HWXLR8/niubkb/README.md

# 牛逼KB
An ergonomic ortholinear keyboard inspired by the Atrues.
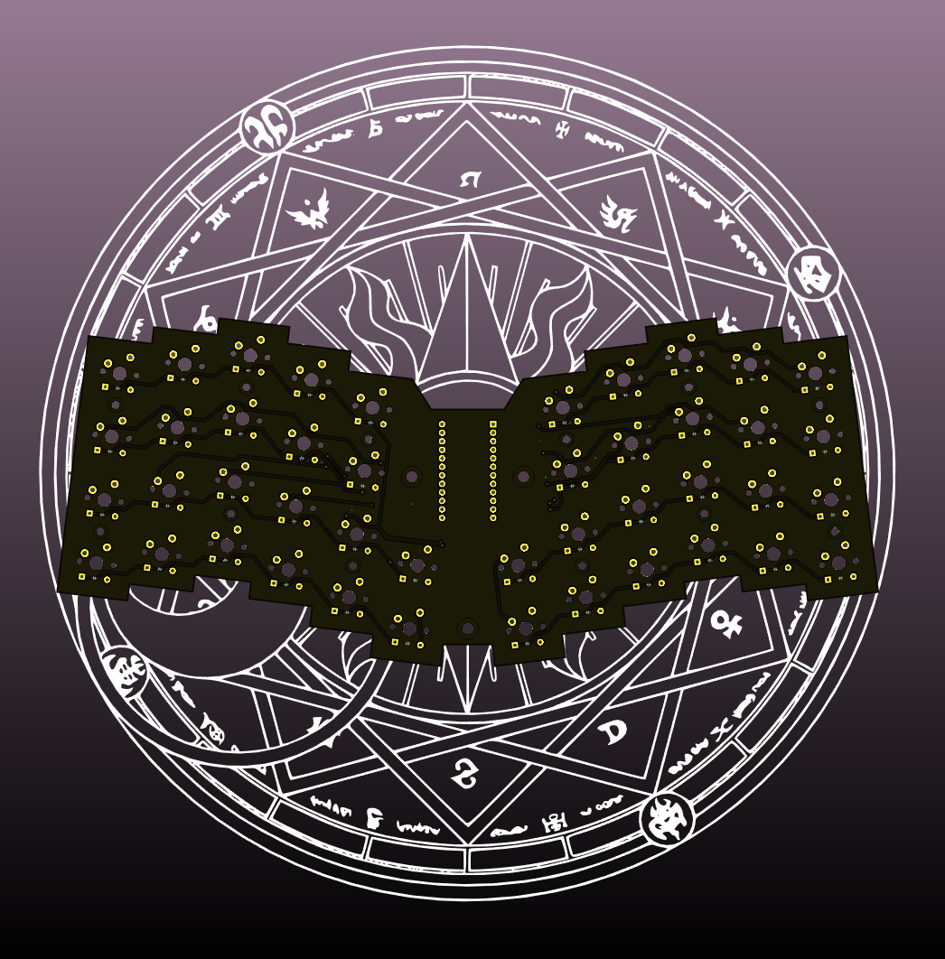
[picture p1: pcb/pic/pcb.png]
