HWXLR8/niubkb/fw/README.md

### Layout

L0

```
    =      Q     W     F     P     G         ||        J     L     U     Y     ;     `
    /      A     R     S     T     D         ||        H     N     E     I     O     '
    FN     Z     X     C     V     B    DEL  ||  ×     K     M     ,     .     ×     ×
    ESC    ×     ×    GUI  SHIFT  BSPC  CTRL || ALT  SPACE   FN    -     ×     ×   ENTER
```

L1

```
    ×     !     @     UP    {     }         ||       PGUP   7     8     9     *     ×
    ×     #    LEFT  DOWN RIGHT   $         ||       PGDN   4     5     6     +     ×
    ×     [     ]     (     )     &     ×   ||  ×     ×     1     2     3     \     ×
    ×     ×    INS   GUI  SHIFT  BSPC  CTRL || ALT  SPACE   ×     .     0     =     ×
```

Hold `FN` for layer 1. `×` is unmapped; on higher layers it falls back to the layer below.
