HWXLR8/niubkb/case/dxf/base_left.dxf

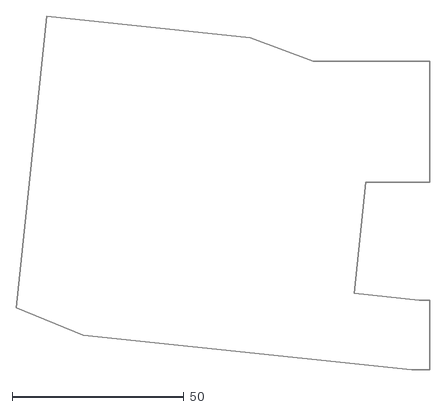
[picture p2: CAD file, 2024-02-07]
case/dxf/base_left.dxf
120.7 x 103.1
