HWXLR8/niubkb/case/dxf/hole_support_left.dxf

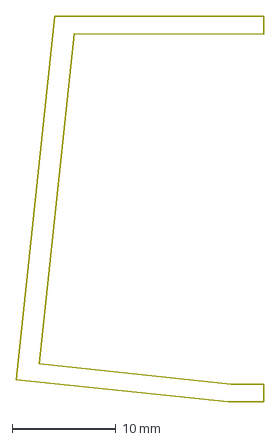
[picture p3: CAD file, 2024-02-07]
case/dxf/hole_support_left.dxf
23.9 x 37.2 mm
