HWXLR8/niubkb/case/dxf/base.dxf

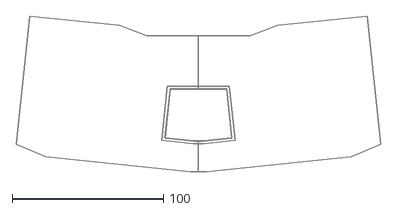
[picture p4: CAD file, 2024-02-07]
case/dxf/base.dxf
241.3 x 103.1
