HWXLR8/niubkb/case/dxf/outline.dxf

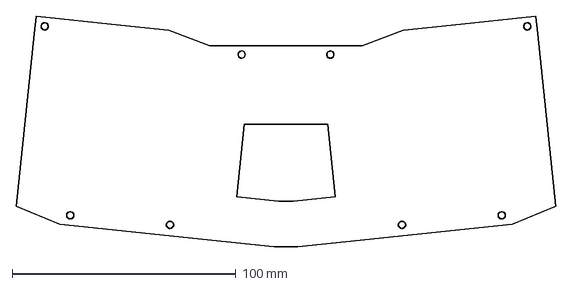
[picture p5: CAD file, 2024-02-07]
case/dxf/outline.dxf
241.3 x 103.1 mm
