HWXLR8/niubkb/pcb/niu-v5.kicad_pcb

## KiCad design pcb/niu-v5.kicad_pcb (2025-12-14)

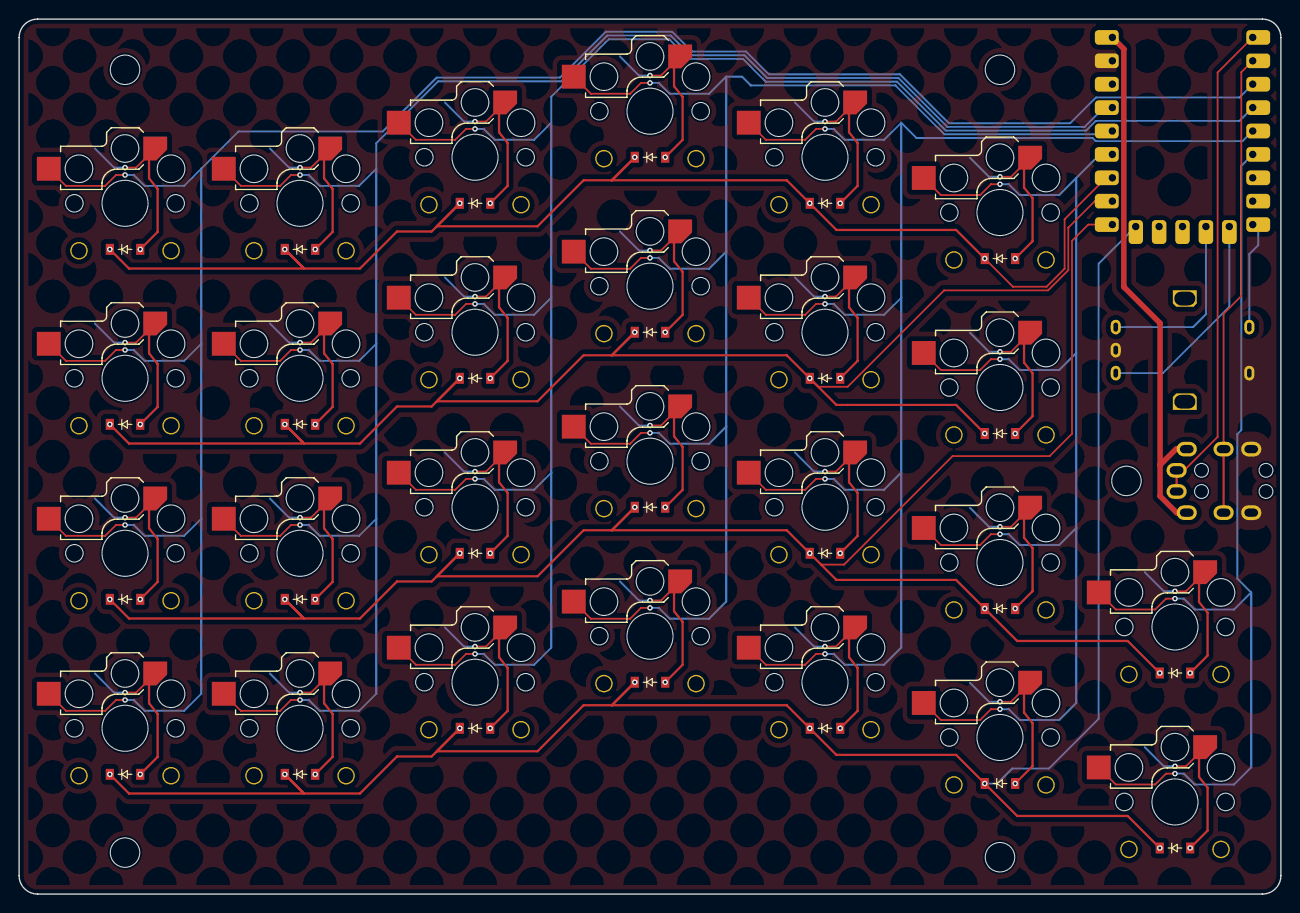
[picture p6: board niu-v5.kicad_pcb from above]

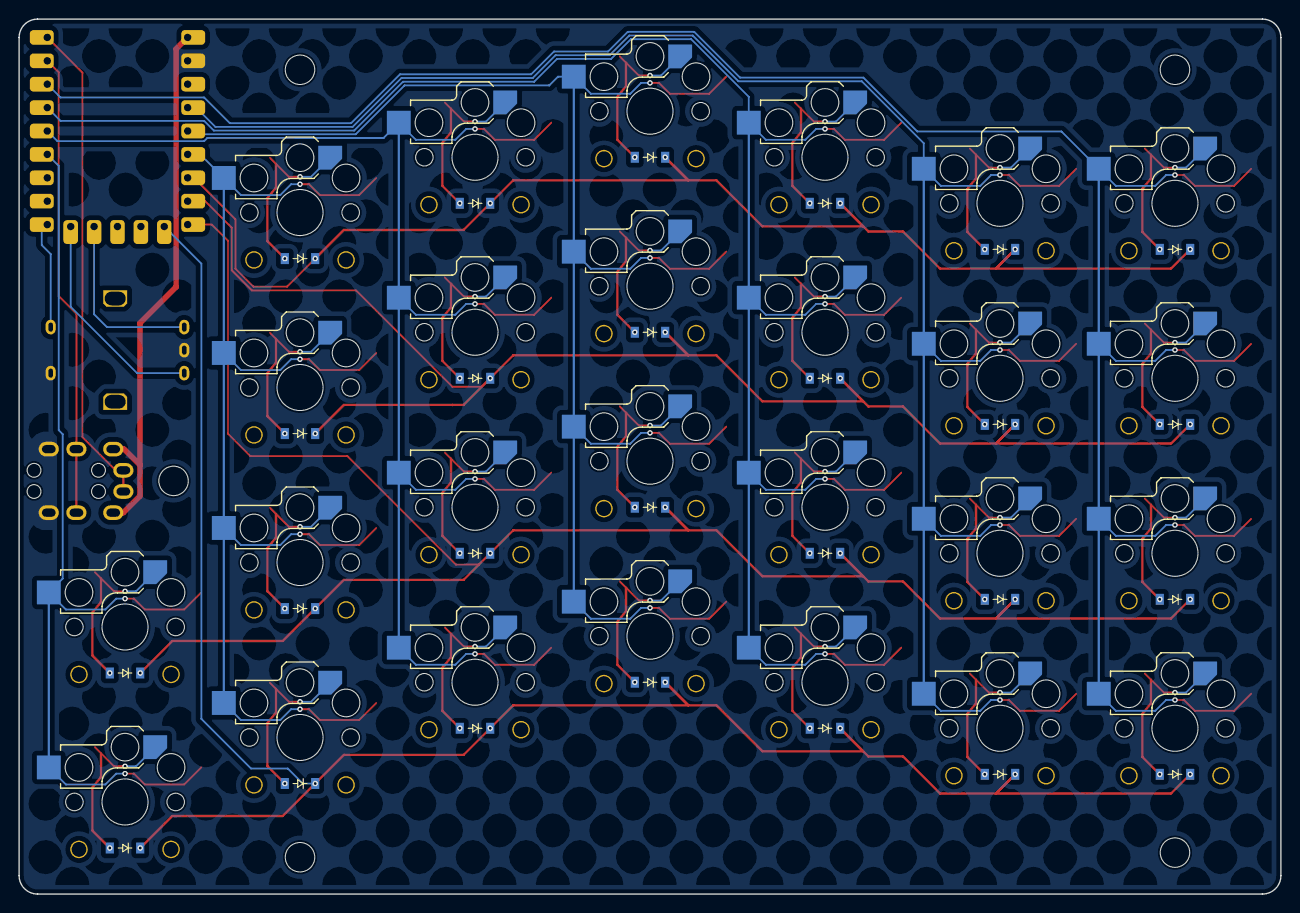
[picture p7: board niu-v5.kicad_pcb from below]

Board: 2 copper layers, 137.0 x 95.0 mm, 60 parts (26 on the bottom side), 44 nets.

Parts:
D1, D2, D3, D4, D5, D6, D7, D8, D9, D10, D11, D12, D13, D14, D15, D16, D17, D18, D19, D20, D21, D22, D23, D24, D25, D26: diode_tht_sod123
MCU1: mcu_rp2040_zero
MH1, MH2, MH3, MH4, MH5: mounting_hole_npth
RE1: rotary_encoder_ec11_ec12
S1, S2, S3, S4, S5, S6, S7, S8, S9, S10, S11, S12, S13, S14, S15, S16, S17, S18, S19, S20, S21, S22, S23, S24, S25, S26: switch_choc_v1_v2
TRRS1: trrs_pj320a (reversible)

Connections:
5V: MCU1.1, TRRS1.4
ENC_A: MCU1.14, RE1.A
ENC_B: MCU1.13, RE1.C
ENC_SW: MCU1.15, RE1.S1
GND: MCU1.2, RE1.B, RE1.S2, TRRS1.2
P4: MCU1.4, S5.2, S6.2, S7.2, S8.2
P5: MCU1.5, S13.2, S14.2, S15.2, S16.2
P6: MCU1.6, S21.2, S22.2, S23.2, S24.2
P7: D4.1, D8.1, D12.1, D16.1, D20.1, D24.1, MCU1.7
P8: D3.1, D7.1, D11.1, D15.1, D19.1, D23.1, MCU1.8
P9: D2.1, D6.1, D10.1, D14.1, D18.1, D22.1, D26.1, MCU1.9
P10: D1.1, D5.1, D9.1, D13.1, D17.1, D21.1, D25.1, MCU1.10
P18: MCU1.18, S25.2, S26.2
P19: MCU1.19, S17.2, S18.2, S19.2, S20.2
P20: MCU1.20, S9.2, S10.2, S11.2, S12.2
P21: MCU1.21, S1.2, S2.2, S3.2, S4.2
RX: MCU1.22, TRRS1.3
TX: MCU1.23, TRRS1.5
index_bottom: D17.2, S17.1
index_home: D19.2, S19.1
index_lower: D18.2, S18.1
index_top: D20.2, S20.1
inner_bottom: D21.2, S21.1
inner_home: D23.2, S23.1
inner_lower: D22.2, S22.1
inner_top: D24.2, S24.1
middle_bottom: D13.2, S13.1
middle_home: D15.2, S15.1
middle_lower: D14.2, S14.1
middle_top: D16.2, S16.1
outer_bottom: D1.2, S1.1
outer_home: D3.2, S3.1
outer_lower: D2.2, S2.1
outer_top: D4.2, S4.1
pinky_bottom: D5.2, S5.1
pinky_home: D7.2, S7.1
pinky_lower: D6.2, S6.1
pinky_top: D8.2, S8.1
ring_bottom: D9.2, S9.1
ring_home: D11.2, S11.1
ring_lower: D10.2, S10.1
ring_top: D12.2, S12.1
thumb_bottom: D25.2, S25.1
thumb_lower: D26.2, S26.1
