HWXLR8/niubkb/(threads)

Thread 1 (2024-01-28):

right half columns wired incorrectly

HWXLR8, 2024-01-28:
Right half columns are connected to left half coulmns

HWXLR8, 2024-02-14:
fixed a93c270dc6b5ba568a1e5f0a0621419b011d4649

Closed 2024-02-14.

Thread 2 (2024-02-08):

V2 PCB to-do list

HWXLR8, 2024-02-08:
- [x] fix right hand column wiring with `mirror.column_net`
- [x] increase pad size of MX key
- [x] increase pad size of pro micro
- [x] move pro micro silkscreen outline to non silk layer
- [x] increase tilt slightly
- [x] add thumb keys to innermost column and bottom row

Closed 2024-02-14.

Thread 3 (2024-03-21):

V3 PCB to-do list

HWXLR8, 2024-03-21:
- [x] Move pinky row down slightly
- [ ] Add MX hotswaps
- [x] Straighten USB cutout corners

HWXLR8, 2024-03-31:
closing issue, hotswaps no longer in scope for this release.

Closed 2024-03-31.

Thread 4 (2024-03-21):

Remove SMD pads from diode footprint

HWXLR8, 2024-03-21:

HWXLR8, 2024-03-31:
closed by https://github.com/HWXLR8/ergogen/commit/dd68e75cb2b535fe7f789b9a35200af72659fb3d

Closed 2024-03-31.

Thread 7 (2025-05-09):

PCB is warping

HWXLR8, 2025-05-09:
v4 PCBs arrived warped, could be due to asymmetrical design from the rotary encoder.
