HWXLR8/niubkb/(commit log)

2023-02-20 Add trrs. Change some units from cx/cy to default units. Adjust tab spacing to make room for mounting posts.
2023-02-23 add some mounting holes
2023-02-23 un-rotate footprints
2023-02-23 tentative tab+hole placement complete
2023-02-28 add routed pcb and silkscreen footprint library
    [niu_routed.kicad_pcb]
2023-11-26 remove tabs/holes in yaml in favor of manual placement in kicad
    [niu-merged.kicad_pcb]
2024-01-14 add routed merged pcb
    [niu-merged.kicad_pcb]
2024-01-14 fix hole sizes
    [niu-merged.kicad_pcb]
2024-01-14 finalize merged pcb
    [niu-merged.kicad_pcb]
2024-01-14 remove silkscreen on promicro
    [niu-merged.kicad_pcb]
2024-01-14 rename niu_routed -> niu_split
    [niu-split.kicad_pcb]
2024-01-14 move pcbs to separate dir
    [niu-merged.kicad_pcb, niu-split.kicad_pcb]
2024-01-14 add pcb pics
2024-01-31 add script for generating mounting holes in openscad
2024-01-31 add case (WIP)
    [case.scad]
2024-02-07 add case
    [base.dxf, base_left.dxf, case.scad, hole_support_left.dxf, outline.dxf]
2024-02-07 add kicad project files to gitignore
2024-02-11 add auto generated pcb outline
2024-02-13 add mounting holes
2024-02-14 fix right hand column wiring
2024-02-15 remove split keyboard and associated footprints
    [niu-split.kicad_pcb]
2024-02-15 update pcb pics
2024-03-30 add m2 mounting holes, reduce outline size (WIP)
2024-03-31 Finalize V3 layout
    - drop pinky column stagger
    - rename rows
    - place all mounting holes
    - clean up board outline
    - add second thumb key
2024-04-09 route compact pcb
    [niu-compact.kicad_pcb]
2024-05-13 [PCB] Add silkscreen, change hatch fill to solid
    [niu-compact.kicad_pcb]
2024-05-14 [DOC] Update PCB pics
2024-05-14 [DOC] Add missing PCB pic
2025-02-16 [git] ignore backup files and gerbers
2025-02-16 [pcb] update naming scheme to use version numbers
    [niu-v1.kicad_pcb, niu-v3.kicad_pcb]
2025-03-04 prototype v4
    [niu-v4.kicad_pcb]
2025-04-27 finalize v4
    [niu-v4.kicad_pcb]
2025-12-14 add niu-v5
    [niu-v5-plate.kicad_pcb, niu-v5.kicad_pcb]
2026-10-02 move ESC/ENTER to bottom corners
